TheOneCurly/CameraStabilization/Website/src/assets/brocker.jpg

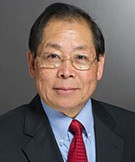
Website/src/assets/brocker.jpg
