TheOneCurly/CameraStabilization/Website/src/assets/two-kittens-cute.jpg

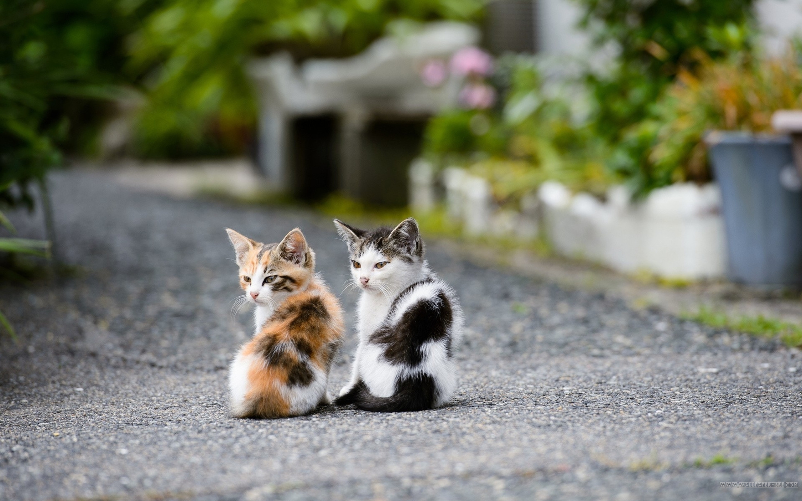
Website/src/assets/two-kittens-cute.jpg
