TheOneCurly/CameraStabilization/Website/src/assets/CameraView.png

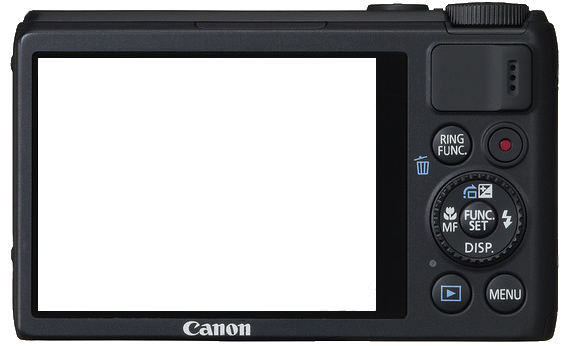
Website/src/assets/CameraView.png
