TheOneCurly/CameraStabilization/Test_results/IMU_hand_error_measurements.xlsx

 | x | exp | error | deg diff
0 | 135.4 | 135.4 | 0 | 0 | ref
5 | 133.1 | 130.4 | 2.070552147 | 2.7
10 | 127.5 | 125.4 | 1.674641148 | 2.1
45 | 96.9 | 90.4 | 7.190265487 | 6.5
90 | 47.9 | 45.4 | 5.50660793 | 2.5
 |  |  |  | 0
0 | 135.4 | 137.9 | 1.812907904 | 2.5
5 | 133.1 | 132.9 | 0.1504890895 | 0.2
10 | 127.5 | 127.9 | 0.3127443315 | 0.4
45 | 96.9 | 92.9 | 4.305705059 | 4
90 | 47.9 | 47.9 | 0 | 0 | ref
 |  |  |  | 0
0 | 131.9 | 134.5 | 1.933085502 | 2.6
5 | 127.6 | 129.5 | 1.467181467 | 1.9
10 | 122.4 | 124.5 | 1.686746988 | 2.1
45 | 90.4 | 89.5 | 1.005586592 | 0.9
90 | 44.5 | 44.5 | 0 | 0 | ref
 |  |  |  | 0
0 | 131.9 | 131.9 | 0 | 0 | ref
5 | 127.6 | 126.9 | 0.5516154452 | 0.7
10 | 122.4 | 121.9 | 0.4101722724 | 0.5
45 | 90.4 | 86.9 | 4.027617952 | 3.5
90 | 44.5 | 41.9 | 6.205250597 | 2.6
 |  |  | 2.519448119 | 2.23125
