TheOneCurly/CameraStabilization/(threads)

Thread 1 (2016-08-31):

Question about hardware

motomax, 2016-08-31:
Hi!

This is not exactly an issue but more of getting more info kind of thing. I couldn't find another way to communicate! Sorry!

Anyways, I am also trying to build a 3-axis camera stabilizer gimbal. Here are my parts so far:
- Arduino Uno
- MPU9250 (2)
- Turnigy 5208 Gimbal Motors (3)
- Hobbywing 15A ESC XRotor (3)

Unfortunately, the ESC will not allow me to run the motors properly, so I did some research and I plan to use L6235/L6229 chips instead. I have a couple of questions before purchasing these chips:
1) How do you connect the chips to the Arduino and the motor? Do the Hall inputs on the chip need to be connected?
2) Just making sure, the L6235 chip has reverse speed and takes in one PWM input from the Arduino to run the motor, right?
3) I see that you made your own PWM. Is it possible to still run the L6235 chip using the regular analogWrite()?
4) Did you use the evaluation board or just the chip?

Sorry for posting here! I've been trying to get the ESC to work for 5 straight days but to no avail, so I want to make sure that this chip is a working alternative.

Thanks!

Max G.
Can also contact me at motomaximusprime@gmail.com

TheOneCurly, 2016-08-31:
Let me start off with this was a school project and it never did work quite right, but I'll do my best to tell you what we learned.

1. Take a look at the L6235 data sheet and pay careful attention to the Typical Application circuit diagram, it tells you pretty much everything you need to know about the I/O on the chip. The chip takes in 2 digital control signals and one fw/rev PWM. The hall effect sensors are necessary as far as I know to allow the the controller to do proper speed control.

2. Yes, as I recall the Fwd/Rev pin on the L6235 runs forward over 50% duty and reverse on less that 50% duty

3. We had issues with coil whine running at the standard arduino PWM frequency. Depending on your motors and circuit you may not have this issue, but turning the frequency up fixed it for us.

4. We used 3 of the DIP package chips and designed our own IC's to mount them on. We designed the IC to match the Typical Application circuit and to mount nicely to the back of our motor mounts. OSH Park was really nice because we got 3 copies of the board.

Good luck with your project! If you have any other questions I'm happy to try and answer them.

Alex W.

motomax, 2016-08-31:
Aw man :(. Sad to hear it didn't really work. What happened, if I may ask?
I really appreciate your answers though, helps clarify a lot! I do have some follow up questions:
1) Do you know if the Turnigy 5208 gimbal motors have hall sensors in them already? If so, I just have connect each wire to the corresponding Hall input on the chip right?
2) Could you clarify what you mean by "designed the IC to match the Typical Application circuit." Does that mean we have to make additional circuitry, like add capacitors/op-amps/etc.? From what I learned so far about the chip, my understanding is that I just need to connect to ground, external battery, the 3 outputs to the motor, 3 inputs into Hall, and PWM input from Arduino. Or is there more than meets the eye ...

Also, just a non-related question, but have you tried using fuzzy logic instead of PID? Cause I'm planning to implement fuzzy, and although research papers I've found on the web say fuzzy is much better than PID, all the controllers I've seen use PID... so just curious.

Thank you very much for your time! Sorry for all the questions. I'm going into my 2nd year for undergrad in EE, so this project is a big big learning experience.

Max G.

TheOneCurly, 2016-09-01:
By the end, most of our problems were control algorithm related. The software as committed here produces some very jerky motion that vaguely moves in the opposite direction of the user's motion.

1. They do not. We attached 3 sensors on each motor at 120 degree offsets.
2. If you look at page 26 in the [L6235](http://www.st.com/content/ccc/resource/technical/document/datasheet/e0/55/d7/b1/d5/06/47/96/CD00002347.pdf/files/CD00002347.pdf/jcr:content/translations/en.CD0000234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) data sheet you can see that yes there are some external components needed for the driver to operate. It's pretty common for larger and variable components to be left outside of packaged components. I just committed MotorController.zip which contains the EagleCAD project for the PCB we designed. It's designed for the DIP package version of the L6235 with a DIP socket, and through-hole passive components.

I have no experience in fuzzy logic, but it sounds like a pretty fun twist on this project.

I've also committed CameraStabilizationII_revision_8.docx, our final design document. You may find some of the research and explanations helpful in designing your project.

motomax, 2016-09-01:
Was it hard attaching the Hall sensors? It seems a little sketch, does the installment have to be very accurate?
Anyways, thanks for all the information and documentation. They really help! It seems like the L6235 seems complicated to do electrically, but since you made a PCB of it already and it seems simple to program through Arduino, I might consider getting the L6235 and Hall sensors. If things do get too complicated, I'll try to use manually code PWM and make my own H-bridges.

Btw, I see you guys use tinkercad! (90% sure) Here's my design (in progress): https://tinkercad.com/things/7z9HyL7pKjg.

TheOneCurly, 2016-09-01:
We ended up 3D printing custom motor mounts that had cutouts for the sensors. Those were also nice because we included a mount for the L6235 board on the back, so the runs for the sensor feedback and motor power lines were relatively short.
