TheOneCurly/CameraStabilization/Controller/PID.cpp

/*
 *
 *	PID.cpp
 *
 *	Team: Marit Brocker, Mitch Cook, Alex Wilson, Caleb Disbrow
 *	Creation Date: 14 March 2015
 *	Project: RIT Senior Design 2014-2015 -- Camera Stabilization
 *
 *	Description: Funtionality for the PID controller for a 3-axis camera stabilization system.
 *				 Includes code to adjust the speed and movement direction of 3-phase BLDC motors
 *				 based on the input from a 6050 MPU.
 *
 */

/***************************** Include Files *********************************/

#include "Variables.h"
#include "PID.h"

/************************** Constant Definitions *****************************/
/**************************** Type Definitions *******************************/
/***************** Macros (Inline Functions) Definitions *********************/
/************************** Function Prototypes ******************************/
/************************** Variable Definitions *****************************/
//For each of the following enables:
//	True means the axis is stabilized
//	False means the axis is free floating. 
float baseAngles[3];
float errorBaseAngles[3];

const int MOTOR_STOP_DUTY = 50;
const int MOTOR_HALF_FWD_DUTY= 75;
const int MOTOR_FULL_FWD_DUTY = 100;
const int MOTOR_HALF_REV_DUTY = 25;
const int MOTOR_FULL_REV_DUTY = 0;

const int X_MAX_ANGLE = 90;
const int Y_MAX_ANGLE = 90;
const int Z_MAX_ANGLE = 90;

const int ANGLE_THRESHOLD = 2;
const int DUTY_CONSTRAIN = 1000;

static int system_weight = 800;
static int system_power = 100;
static int system_performance = 100;

float xErrorSum = 0, yErrorSum = 0, zErrorSum = 0;

static float kp = 1;
static float ki = 0.2;
int t = 0;
static int t_last = 0;
/**
 *
 * Calculates the movement of each of the 3 three-phase BLDC motors as they 
 * stabilize the platform. Movement is based on a single 6050MPU IMU that 
 * senses the user's movement. This process does not use any error correction. 
 *
 * @param	
 *
 * @return	Array of ints that correlate to the PWM signal needed for each of the
 *			three motors. 
 *
 *
 ******************************************************************************/
int* PIDMovementCalc(float* angles){
    int* dutyCycles = (int*)malloc(3*sizeof(int));
    
    if(angles[0] > baseAngles[0] + ANGLE_THRESHOLD){
        dutyCycles[0] = MOTOR_HALF_FWD_DUTY;
    }else if(angles[0] < baseAngles[0] - ANGLE_THRESHOLD){
        dutyCycles[0] = MOTOR_HALF_REV_DUTY;   
    }else{
        dutyCycles[0] = MOTOR_STOP_DUTY;
    }
    
    if(angles[1] > baseAngles[1] + ANGLE_THRESHOLD){
        dutyCycles[1] = MOTOR_HALF_FWD_DUTY;
    }else if(angles[1] < baseAngles[1] - ANGLE_THRESHOLD){
        dutyCycles[1] = MOTOR_HALF_REV_DUTY;   
    }else{
        dutyCycles[1] = MOTOR_STOP_DUTY;
    }
    
    if(angles[2] > baseAngles[2] + ANGLE_THRESHOLD){
        dutyCycles[2] = MOTOR_HALF_FWD_DUTY;
    }else if(angles[2] < baseAngles[2] - ANGLE_THRESHOLD){
        dutyCycles[2] = MOTOR_HALF_REV_DUTY;   
    }else{
        dutyCycles[2] = MOTOR_STOP_DUTY;
    }
    
    return dutyCycles;
}


/*******************************************************************************
 *
 * Calculates the movement of each of the 3 three-phase BLDC motors as they 
 * stabilize the platform. Movement is based on a single 6050MPU IMU that 
 * senses the user's movement. This process does use error correction.
 *
 * @param	
 *
 * @return	Array of ints that correlate to the PWM signal needed for each of the
 *			three motors. 
 *
 *
 ******************************************************************************/
int* PIDMovementCalc_withError(float* errorAngles, float* angles){
    int* dutyCycles = (int*)malloc(3*sizeof(int));
    t = millis()/1000;
    
    // Main IMU error
    xControl = (angles[2] - baseAngles[2]);
    yControl = (angles[1] - baseAngles[1]);
    zControl = (angles[0] - baseAngles[0]);
    
    // Error IMU error
    xError = (errorAngles[0] - errorBaseAngles[0]);
    yError = (errorAngles[1] - errorBaseAngles[1]);
    zError = (errorAngles[2] - errorBaseAngles[2]);
    
    xErrorSum += xError*(t-t_last);
    yErrorSum += yError*(t-t_last);
    zErrorSum += zError*(t-t_last);
    
//    Serial.print("XControl: ");
//    Serial.println(xControl);
//    Serial.print("YControl: ");
//    Serial.println(yControl);
//    Serial.print("ZControl: ");
//    Serial.println(zControl);
//    
//    Serial.print("Xerror: ");
//    Serial.println(xError);
//    Serial.print("YError: ");
//    Serial.println(yError);
//    Serial.print("ZError: ");
//    Serial.println(zError);
//    
//    Serial.print("X enabled: ");
//    Serial.println(X_control_en);
    
    // X-axis
    if(X_control_en && (xControl > ANGLE_THRESHOLD || xControl < -ANGLE_THRESHOLD) && (xControl < X_MAX_ANGLE || xControl > -X_MAX_ANGLE)){
        xDuty = kp*xError + ki*xErrorSum;
        Serial.print("Xduty: ");
        Serial.println(xDuty);
        xDuty = constrain(xDuty, -DUTY_CONSTRAIN, DUTY_CONSTRAIN);
        dutyCycles[0] = map(xDuty, -DUTY_CONSTRAIN, DUTY_CONSTRAIN, 25, 75);
    }else if(!X_control_en){
        xError = (angles[0] - baseAngles[0]) - (errorAngles[0] - errorBaseAngles[0]);
        xDuty = kp*xError;
        xDuty = constrain(xDuty, -DUTY_CONSTRAIN, DUTY_CONSTRAIN);
        dutyCycles[0] = map(xDuty, -DUTY_CONSTRAIN, DUTY_CONSTRAIN, 25, 75);
    }else{
        dutyCycles[0] = 50;
    }
    
    // Y-axis
    if(Y_control_en && (yControl > ANGLE_THRESHOLD || yControl < -ANGLE_THRESHOLD) && (yControl < Y_MAX_ANGLE || yControl > -Y_MAX_ANGLE)){
        yDuty = -1*(kp*yError+ ki*yErrorSum);
        Serial.print("Yduty: ");
        Serial.println(yDuty);
        yDuty = constrain(yDuty, -DUTY_CONSTRAIN, DUTY_CONSTRAIN);
        dutyCycles[1] = map(yDuty, -DUTY_CONSTRAIN, DUTY_CONSTRAIN, 25, 75);
    }else if(!Y_control_en){
        yError = -1*(angles[1] - baseAngles[1]) - (errorAngles[1] - errorBaseAngles[1]);
        yDuty = kp*yError;
        yDuty = constrain(yDuty, -DUTY_CONSTRAIN, DUTY_CONSTRAIN);
        dutyCycles[1] = map(yDuty, -DUTY_CONSTRAIN, DUTY_CONSTRAIN, 25, 75);
    }else{
        dutyCycles[1] = 50;
    }
    
    // Z-axis
    if(Z_control_en && (zControl > ANGLE_THRESHOLD || zControl < -ANGLE_THRESHOLD) && (zControl < Z_MAX_ANGLE || zControl > -Z_MAX_ANGLE)){
        zDuty = -1*(kp*zError+ ki*zErrorSum);
        Serial.print("Zduty: ");
        Serial.println(zDuty);
        zDuty = constrain(zDuty, -DUTY_CONSTRAIN, DUTY_CONSTRAIN);
        dutyCycles[2] = map(zDuty, -DUTY_CONSTRAIN, DUTY_CONSTRAIN, 25, 75);
    }else if(!Z_control_en){
        zError = -1*(angles[2] - baseAngles[2]) - (errorAngles[2] - errorBaseAngles[2]);
        zDuty = kp*zError;
        zDuty = constrain(zDuty, -DUTY_CONSTRAIN, DUTY_CONSTRAIN);
        dutyCycles[2] = map(zDuty, -DUTY_CONSTRAIN, DUTY_CONSTRAIN, 25, 75);
    }else{
        dutyCycles[2] = 50;
    }
    
    t_last = t;
    
    return dutyCycles;
}




/****************************PID ADJUSTMENT FUNCS*****************************/



/*******************************************************************************
 *
 * Adjusts the amount of movement required on the output of the PID based on the
 * weight of the camera being stabilized. Less force is required for lighter cameras,
 * and more force is required for heavier cameras
 *
 * @param	weight - the current weight of the item held by the system in ounces
 *
 * @return	Whether or not the weight adjustement was successful.
 *
 ******************************************************************************/
static bool AdjustWeight(int weight){
	system_weight = weight;
}


/*******************************************************************************
 *
 * Adjusts the amount of movement required on the output of the PID based on the
 * remaining charge of the battery. Lower charege requires additional force be used
 * to maintain desired movement. 
 *
 * @param	batteryCharge - amount of charge remaining
 *
 * @return	Whether or not the power adjustement was successful.
 *
 *
 ******************************************************************************/
static bool AdjustPower(int batteryCharge){
	system_power = batteryCharge;
}


/*******************************************************************************
 *
 * Adjusts the amount of movement based on the performance desired by the user,
 * which will allow the user to introduce their own level of 'shake' into the system.
 *
 * @param	adjustValue - 0-100 - percentage of stabilization to perform.
 *
 * @return	Whether or not the performance adjustement was successful.
 *
 *
 ******************************************************************************/
static bool AdjustPerformance(int adjustValue){
	system_performance = adjustValue;
}


/******************************************************************************
 *
 * stabilize the X Axis of the Gimbal
 *
 * @return	current state of holding - true is stablized, false is free movement.
 *
 *
 ******************************************************************************/
bool holdXAxis(){

	X_control_en = true;

	return X_control_en;

}


/******************************************************************************
 *
 * stabilize the Y Axis of the Gimbal
 *
 * @return	current state of holding - true is stablized, false is free movement.
 *
 *
 ******************************************************************************/
bool holdYAxis(){

	Y_control_en = true;

	return Y_control_en;
}


/******************************************************************************
/**
 *
 * stabilize the Z Axis of the Gimbal. 
 *
 * @return	current state of holding - true is stablized, false is free movement.
 *
 *
 ******************************************************************************/
bool holdZAxis(){

	Z_control_en = true;

	return Z_control_en;

}


/******************************************************************************

 *
 * Do not stabilize the X Axis, allow it to freely move with the user's movement.
 *
 *
 * @return	current state of holding - true is stablized, false is free movement.
 *
 *
 ******************************************************************************/
bool freeXAxis(){

	X_control_en = false;

	return X_control_en;

}


/******************************************************************************
 *
 * Do not stabilize the Y Axis, allow it to freely move with the user's movement.
 *
 *
 * @return	current state of holding - true is stablized, false is free movement.
 *
 *
 ******************************************************************************/
bool freeYAxis(){

	Y_control_en = false;

	return Y_control_en;

}

/******************************************************************************
 *
 * Do not stabilize the Z Axis, allow it to freely move with the user's movement.
 *
 *
 * @return	current state of holding - true is stablized, false is free movement.
 *
 *
 ******************************************************************************/
bool freeZAxis(){

	Z_control_en = false;

	return Z_control_en;
}

/******************************************************************************
 *
 * Set starting IMU values
 *
 *
 * @return
 *
 *
 ******************************************************************************/
void setBaseAngles(float* base, int imu){
    if(imu == 0){
        baseAngles[0] = base[0];
        baseAngles[1] = base[1];
        baseAngles[2] = base[2];
//        Serial.println(F("base angles"));
//        Serial.println(baseAngles[0]);
//        Serial.println(baseAngles[1]);
//        Serial.println(baseAngles[2]);
    }else if(imu == 1){
        errorBaseAngles[0] = base[0];
        errorBaseAngles[1] = base[1];
        errorBaseAngles[2] = base[2];
//        Serial.println(F("error base angles"));
//        Serial.println(errorBaseAngles[0]);
//        Serial.println(errorBaseAngles[1]);
//        Serial.println(errorBaseAngles[2]);
    }
}

/******************************************************************************
 *
 * Set position to hold the platorm at for each IMU
 *
 *
 * @return
 *
 *
 ******************************************************************************/
void setHoldPosition(float* control, float* error){
     
}
