TheOneCurly/CameraStabilization/Controller/Variables.h

/*============================================================================================

	Variables.h

	Team: Marit Brocker, Mitch Cook, Alex Wilson, Caleb Disbrow
	Creation Date: 27 April 2015
	Project: RIT Senior Design 2014-2015 -- Camera Stabilization

	Description: Holds variables for UI interaction with overall system.

  ============================================================================================ */


#ifndef _VARIABLES_H_
#define _VARIABLES_H_

#include "Arduino.h"
	//For each of the following enables:
	//	True means the axis is stabilized
	//	False means the axis is free floating. 
	static bool X_control_en = true;
        static bool Y_control_en = true;
	static bool Z_control_en = true;

	static float xError, yError, zError;
	static float xControl, yControl, zControl;
	static float xDuty, yDuty, zDuty;

	static bool in_UI = 0;
	
#endif 
