TheOneCurly/CameraStabilization/(commit log)

2015-02-02 adding test code for imu
2015-02-08 initial draft of PWM test code
2015-02-08 updating delays, prints, and making sure we dont go from full forward to full reverse
    [PWM_test.ino, PWM_test_analog.ino]
2015-02-10 fixed a syntax error
    [PWM_test.ino, PWM_test_analog.ino]
2015-02-10 adding results from hand measurements for IMU
    [IMU_hand_error_measurements.xlsx]
2015-02-11 Removed unecessary code from arduino file
2015-02-19 Created controller.ino, placed imu code inside
2015-02-19 Created timer test file, merged working timer code into controller.ino
2015-02-20 Added test code for position and motor movement
2015-02-21 updating pin
2015-02-25 Added Josh's PWM Library
2015-02-26 Added PWM library to PWM test code
2015-02-26 playing around with motor stuff
2015-03-13 Removing AVR Library, adding ARM LCD Library for ST7565 control
2015-03-14 Adding framework for additional PID functionality.
2015-03-23 Website: Created landing pages for meet the team, affiliations, and about. Created basic framework for meet the team
2015-04-04 Created imucontroller class
2015-04-04 updating imu controller interior
2015-04-04 Added P to PID controller
2015-04-04 pid tweaks
2015-04-06 Added base angle values to PID calculations, general code cleanup
2015-04-07 initialize imu and set the origin to the current position after the imu stabilizes
2015-04-07 Added support for 2 imu's
2015-04-07 Refactored imucontroller ot move interrupt management out of the class. They are now set outside the class, before init is run.
2015-04-08 Define framework for LCD controller library, add required LCD library files.
2015-04-09 Added init for imu_error
2015-04-09 Set base angles for both imu's
2015-04-10 commented out motor pin initializations because they were breaking serial/everything, re-added some code for base angles that was removed
2015-04-14 updating formatting, prints, main loop, memory usage
2015-04-14 Added constraints to PID pwm output
2015-04-18 pins for motors
2015-04-20 reorder a few imu polls, fix fifo overflows by resetting the queue before moving on to another poll. we will always be polling imu's back to back, so when you are done with one, you can clear it out 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
    [Controller.ino, IMUController.cpp, PID.cpp, PWM_test_analog.ino]
2015-04-24 Added LCD library to controller, attached pins to interrupt handlers
2015-04-24 Pin numbers now reflect board changes
2015-04-24 reassign interrupt pins:
2015-04-27 Added variables.h to allow for UI control of locking axes, reading angle values, and current duty cycles
2015-04-27 Push to maintain previous functionality before modifying to remove adjust and reset functionality within axis control and menu structure changes as a result.
    [LCD_Controller.cpp, LCD_Controller.h]
2015-04-27 Modified files to eliminate adjust axis and reset axis options, modified menu structure to reduce subpages as a result
    [LCD_Controller.cpp, LCD_Controller.h]
2015-04-28 Fixed missing includes, fixed bitmap call erros and function mismatches
    [LCD_Controller.cpp, LCD_Controller.h]
2015-04-28 Modified debouncing code for JS and Butt, to be tested with full controller and interrupts
2015-04-28 Fixed the missing LCD print call for the LCD initialization process.
    [LCD_Controller.cpp]
2015-04-28 Added ready variable to tell the UI when IMUs have initialized
2015-04-28 Controller now calls sys_init_complete when both IMUs have stabilized
    [Controller.ino, Variables.h]
2015-04-28 Modifying interrupt trigger for joystick and buttons
2015-04-28 Added raw IMU read to IMU_TEST
2015-04-28 remove interrupts, comment out a lot of code. initialize the two imu's and then just poll them
2015-04-28 add base angle and duty cycles calculations back in. if the poll correctly calculates an angle, then this should work
    [Controller.ino, IMUController.cpp, IMUController.h]
2015-04-29 Cleaned up code for functionality reduction, fixed formatting when printing.
    [LCD_Controller.cpp, LCD_Controller.h]
2015-04-29 Fixed compiler issues with function calls/variables mismatch issues.
    [LCD_Controller.cpp, LCD_Controller.h]
2015-04-29 Modified varaible tracking for menus, fixed entering UI mode, using a return rather than sharred flag
    [Controller.ino, LCD_Controller.cpp, LCD_Controller.h, Variables.h]
2015-04-29 Added Framework and debugging for dealing with Drift
    [Controller.ino]
2015-04-30 Fixed PID control checks
    [Controller.ino, IMUController.cpp, PID.cpp]
2015-04-30 Attempted accelerometer correction
2015-04-30 Added consts to PID
2016-08-31 Added Eagle files for the motor controller PCB
