TheOneCurly/CameraStabilization/(notices)

Notices in the files:
IMU_test/sandbox/MPU6050_DMP6/FreeIMU.h:
This program is free software: you can redistribute it and/or modify
it under the terms of the version 3 GNU General Public License as
published by the Free Software Foundation.
